QuickLogic-Corp/Salinas/docs/c19054_SALINAS_BOM.XLSX

Sheet: V1.11
QUICK LOGIC | Salinas Evaluation (ETH) | REV: 1.11 (09/14/20)
Value | PCB Footprint | Part Reference | Quantity | DESCRIPTION
0.1uF | SMD_0402 | C1,C3,C5,C7,C9,C10,C13,C15,C17,C19,C21,C23,C25,C27,C29,C32,C36,C49-C57,C59-C63,C65-C68,C70-C95 | 61 | C,.1U,16V,10%,X7R,0402,CR
4.7uF | SMD_0603 | C2,C4,C6,C8,C11,C12,C14,C16,C18,C20,C22,C24,C26,C28,C30,C31,C48,C58,C64 | 19 | C,4.7U,6.3V,10%,X5R,0603,CR
1000pF | SMD_0603 | C33,C38-C40 | 4 | C,1000P,50V,10%,X7R,0603,CR
4.7uF | SMD_0805 | C34 | 1 | C,4.7U,10V,10%,X5R,0805,CR
10uF | SMD_0603 | C35 | 1 | C,10U,6.3V,10%,X5R,0603,CR
10uF | SMD_0805 | C37 | 1 | C,10U,10V,10%,X5R,0805,CR
1uF | SMD_0805 | C41-C44 | 4 | C,1U,16V,10%,X7R,0805,CR
8.2pF | SMD_0402 | C45,C46 | 2 | 8.2pF ±5% 50V Ceramic Capacitor C0G, NP0 0402 (1005 Metric)
10pF | SMD_0402 | C47 | 1 | C,10P,50V,5%,COG/NPO,0402,CR
120pF | SMD_0402 | C69 | 1 | 120pF ±5% 50V Ceramic Capacitor C0G, NP0 0402 (1005 Metric)
LTST-C193KGKT-5A | SMD_0603 | D1,D4 | 2 | LED,GREEN CLEAR,20MA,2V,0603
LTST-C193KFKT-5A | SMD_0603 | D2 | 1 | LED,ORANGE,CLR,5MA,2V,0603
LTST-C193KSKT-5A | SMD_0603 | D3 | 1 | LED,YELLOW CLR,20MA,2.1V,0603
LTST-C193TBKT-5A | SMD_0603 | D5 | 1 | LED,BLUE,5MA,2.8V,0603
MF-MSMF050-2 | FUSE_MF-MSMF050-2 | F1 | 1 | FUSE,0.5A,15V,PTC RESETBL,1812
PLATED_HOLE_4_40 | PLATED_HOLE_4_40 | H1-H6 | 6
68602-132HLF | CONN_16X2-68602-132HLF | J1-J4 | 4 | Connector Header Through Hole 32 position 0.100" (2.54mm)
SMA | SMA_5-1814832-1 | J5 | 1 | CON,SMA JACK 50OHM,STR,TH
PJ-002A | PJ-002A | J6 | 1 | CON,DC PWR 2.1MM 2.5A,R/A,TH
M20-9991046 | conn_10X1-9991046 | J7 | 1 | CONN HEADER VERT 10POS 2.54MM
Micro USB connector | micro USB | J8 | 1 | Micro USB
M20-7830642 | CONN_6X2-M20-7830642 | J9 | 1 | CONN RCPT 12POS 0.1 GOLD PCB
M20-9990446 | conn_04X1-M20-9990446 | J10,J11 | 2 | CONN HEADER VERT 4POS 2.54MM
M20-7831046 | CONN_10X2-M20-7831046 | J12 | 1 | CONN RCPT 20POS 0.1 TIN PCB
D2520-6002-AR | CONN_10X2-D2520-6002 | J13 | 1 | CONN HEADER VERT 20POS 2.54MM
M20-9981046 | CONN_10X2-M20-9981046 | J14 | 1 | CONN HEADER VERT 20POS 2.54MM
MI0805K400R | L0805 | L1,L4-L6 | 4 | FERRITE BEAD 40 OHM 0805 1LN
742792040 | SMD_0805-742792040 | L2 | 1 | FERRITE BEAD 600 OHM 0805 1LN
742792023 | SMD_0805-742792040 | L3 | 1 | FERRITE BEAD 120 OHM 0805 1LN
OSC_12M | OSC_SMD-3_2X2P5MM-ASEMB | OSC1 | 1 | XTAL OSC XO 12.0000MHZ HCMOS SMD
5-146280-3 | SAMTEC-TSW-101-07-G-T-3PX1 | P1-P3,P5,P6 | 5 | CONN HEADER VERT 3POS 2.54MM
5-146280-2 | SAMTEC-TSW-102-08-S-S-2PX1 | P4,P7-P15,P18,P19,P20 | 13 | CONN HEADER VERT 2POS 2.54MM
SAMTEC-TSW-101-08-S-S | CA40_1P | P16,P17 | 2 | CONN HEADER VERT 1POS
IRLML6246/SOT-23 | SOT23 | Q1-Q4 | 4 | MOSFET N-CH 20V 4.1A SOT-23
0E | SMD_0603 | R1-R16,R40,R44 | 18 | R,0.0OHM,0.1W,1%,0603,TF
10K | SMD_0603 | R39,R41,R47,R51 | 4 | R,10.0K,0.1W,1%,0603,TF
1K | SMD_0603 | R17-R22 | 6 | R,1K,0.1W,1%,0603,TF
0 OHM | SMD_0402 | R23-R28,R30,R31,R34 | 9 | R,0.00OHM,0.0625W,JUMP,0402,TF
33E | SMD_0402 | R29,R53-R55,R57 | 5 | R,33.0OHM,0.0625W,1%,0402,TF
1K | SMD_0402 | R33,R35-R37,R85-R88 | 8 | R,1.0K,0.0625W,1%,0402,TF
10K | SMD_0402 | R45,R48,R52,R74-R79,R93-R96 | 13 | R,10.0K,0.0625W,1%,0402,TF
330 | SMD_0603 | R46 | 1 | R,330OHM,0.1W,1%,0603,TF
1K | SMD_0603 | R50 (DNP) | 1
0E | SMD_0402 | R56,R59-R64,R68-R69,R89-R92 | 13 | R,0.00OHM,0.0625W,JUMP,0402,TF
100K | SMD_0402 | R65-R67 | 3 | R,100K,0.0625W,1%,0402,TF
39E | SMD_0402 | R72,R73 | 2 | R,39 OHM 1% 1/16W 0402
270E | SMD_0402 | R80-R82,R84 | 4 | R,270OHM,0.0625W,1%,0402,TF
100E | SMD_0402 | R83 | 1 | R,100OHM,0.0625W,1%,0402,TF
10M | SMD_0402 | R97 | 1 | R,10.0M,0.0625W,1%,0402,TF
200MSP3T1B1M2QE | SW_DPDT | SW1-SW4 | 4 | SWITCH TOGGLE SPDT 3A 120V
TP_R | TP50S | TP1-TP4 | 4 | TEST PAD
ETH 64-QFN | QFN-64 | U1 (QUICK LOGIC SUPPLY AND INSTALL) | 1
TXS0104EDR | TXS0104EDR | U2-U14 | 13 | IC TRNSLTR BIDIRECTIONAL 14SOIC
MIC68200-3.3YML | MIC68200-3_3YML | U15 | 1 | IC REG LIN 3.3V 1A 10MLF
XC6504A1819R-G | USPQ-4B04-XC6504A1819R-G | U16 | 1 | LDO Voltage Regulators, 1.8 V
MIC5308YMT-TR | MIC5308YMT-TR | U17 | 1 | IC REG LIN POS ADJ 150MA 6TMLF
DLN-4MC/ATSAM3U4CA-AU | LQFP100 | U18 | 1 | IC MCU 32BIT 256KB FLASH 100LQFP
ECMF02-4CMX8 | uQFN-8L | U19 | 1 | COMMON MODE CHOKE 2LN SMD ESD
12MHz-405C35B12M00000 | XTAL_4SMD_5x3p2 | Y1 | 1 | CRYSTAL 12.0000MHZ 13PF SMD
LQH068-0590-16ABEW55L | LQH068-0590-16ABEW55L | SKT FOR U1 (QUICK LOGIC SUPPLY AND INSTALL) | 1 | DNP
0E | SMD_0603 | R32,R42,R43,R49 (DNP) | 4
0E | SMD_0402 | R58,R70,R71 (DNP) | 3
10K | SMD_0603 | R38 (DNP) | 1
5-146280-3 | SAMTEC-TSW-101-07-G-T-3PX1 | P5 | 1 | See change to line #33
DNP
CSP
UPDATE

Sheet: V1.1
QUICK LOGIC | Salinas Evaluation (ETH) | REV: 1.1 (09/08/20)
Value | PCB Footprint | Part Reference | Quantity | DESCRIPTION
0.1uF | SMD_0402 | C1,C3,C5,C7,C9,C10,C13,C15,C17,C19,C21,C23,C25,C27,C29,C32,C36,C49-C57,C59-C63,C65-C68,C70-C95 | 61 | C,.1U,16V,10%,X7R,0402,CR
4.7uF | SMD_0603 | C2,C4,C6,C8,C11,C12,C14,C16,C18,C20,C22,C24,C26,C28,C30,C31,C48,C58,C64 | 19 | C,4.7U,6.3V,10%,X5R,0603,CR
1000pF | SMD_0603 | C33,C38-C40 | 4 | C,1000P,50V,10%,X7R,0603,CR
4.7uF | SMD_0805 | C34 | 1 | C,4.7U,10V,10%,X5R,0805,CR
10uF | SMD_0603 | C35 | 1 | C,10U,6.3V,10%,X5R,0603,CR
10uF | SMD_0805 | C37 | 1 | C,10U,10V,10%,X5R,0805,CR
1uF | SMD_0805 | C41-C44 | 4 | C,1U,16V,10%,X7R,0805,CR
8.2pF | SMD_0402 | C45,C46 | 2 | 8.2pF ±5% 50V Ceramic Capacitor C0G, NP0 0402 (1005 Metric)
10pF | SMD_0402 | C47 | 1 | C,10P,50V,5%,COG/NPO,0402,CR
120pF | SMD_0402 | C69 | 1 | 120pF ±5% 50V Ceramic Capacitor C0G, NP0 0402 (1005 Metric)
LTST-C193KGKT-5A | SMD_0603 | D1,D4 | 2 | LED,GREEN CLEAR,20MA,2V,0603
LTST-C193KFKT-5A | SMD_0603 | D2 | 1 | LED,ORANGE,CLR,5MA,2V,0603
LTST-C193KSKT-5A | SMD_0603 | D3 | 1 | LED,YELLOW CLR,20MA,2.1V,0603
LTST-C193TBKT-5A | SMD_0603 | D5 | 1 | LED,BLUE,5MA,2.8V,0603
MF-MSMF050-2 | FUSE_MF-MSMF050-2 | F1 | 1 | FUSE,0.5A,15V,PTC RESETBL,1812
PLATED_HOLE_4_40 | PLATED_HOLE_4_40 | H1-H6 | 6
68602-132HLF | CONN_16X2-68602-132HLF | J1-J4 | 4 | Connector Header Through Hole 32 position 0.100" (2.54mm)
SMA | SMA_5-1814832-1 | J5 | 1 | CON,SMA JACK 50OHM,STR,TH
PJ-002A | PJ-002A | J6 | 1 | CON,DC PWR 2.1MM 2.5A,R/A,TH
M20-9991046 | conn_10X1-9991046 | J7 | 1 | CONN HEADER VERT 10POS 2.54MM
Micro USB connector | micro USB | J8 | 1 | Micro USB
M20-7830642 | CONN_6X2-M20-7830642 | J9 | 1 | CONN RCPT 12POS 0.1 GOLD PCB
M20-9990446 | conn_04X1-M20-9990446 | J10,J11 | 2 | CONN HEADER VERT 4POS 2.54MM
M20-7831046 | CONN_10X2-M20-7831046 | J12 | 1 | CONN RCPT 20POS 0.1 TIN PCB
D2520-6002-AR | CONN_10X2-D2520-6002 | J13 | 1 | CONN HEADER VERT 20POS 2.54MM
M20-9981046 | CONN_10X2-M20-9981046 | J14 | 1 | CONN HEADER VERT 20POS 2.54MM
MI0805K400R | L0805 | L1,L4-L6 | 4 | FERRITE BEAD 40 OHM 0805 1LN
742792040 | SMD_0805-742792040 | L2 | 1 | FERRITE BEAD 600 OHM 0805 1LN
742792023 | SMD_0805-742792040 | L3 | 1 | FERRITE BEAD 120 OHM 0805 1LN
OSC_12M | OSC_SMD-3_2X2P5MM-ASEMB | OSC1 | 1 | XTAL OSC XO 12.0000MHZ HCMOS SMD
5-146280-3 | SAMTEC-TSW-101-07-G-T-3PX1 | P1-P3,P5,P6 | 5 | CONN HEADER VERT 3POS 2.54MM
5-146280-2 | SAMTEC-TSW-102-08-S-S-2PX1 | P4,P7-P15,P18,P19,P20 | 13 | CONN HEADER VERT 2POS 2.54MM
SAMTEC-TSW-101-08-S-S | CA40_1P | P16,P17 | 2 | CONN HEADER VERT 1POS
IRLML6246/SOT-23 | SOT23 | Q1-Q4 | 4 | MOSFET N-CH 20V 4.1A SOT-23
0E | SMD_0603 | R1-R16,R40,R44 | 18 | R,0.0OHM,0.1W,1%,0603,TF
10K | SMD_0603 | R39,R41,R47,R51 | 4 | R,10.0K,0.1W,1%,0603,TF
1K | SMD_0603 | R17-R22 | 6 | R,1K,0.1W,1%,0603,TF
0 OHM | SMD_0402 | R23-R28,R30,R31,R34 | 9 | R,0.00OHM,0.0625W,JUMP,0402,TF
33E | SMD_0402 | R29,R53-R55,R57 | 5 | R,33.0OHM,0.0625W,1%,0402,TF
1K | SMD_0402 | R33,R35-R37,R85-R88 | 8 | R,1.0K,0.0625W,1%,0402,TF
10K | SMD_0402 | R45,R48,R52,R74-R79,R93-R96 | 13 | R,10.0K,0.0625W,1%,0402,TF
330 | SMD_0603 | R46 | 1 | R,330OHM,0.1W,1%,0603,TF
1K | SMD_0603 | R50 (DNP) | 1
0E | SMD_0402 | R56,R59-R64,R68-R69,R89-R92 | 13 | R,0.00OHM,0.0625W,JUMP,0402,TF
100K | SMD_0402 | R65-R67 | 3 | R,100K,0.0625W,1%,0402,TF
39E | SMD_0402 | R72,R73 | 2 | R,39 OHM 1% 1/16W 0402
270E | SMD_0402 | R80-R82,R84 | 4 | R,270OHM,0.0625W,1%,0402,TF
100E | SMD_0402 | R83 | 1 | R,100OHM,0.0625W,1%,0402,TF
10M | SMD_0402 | R97 | 1 | R,10.0M,0.0625W,1%,0402,TF
200MSP3T1B1M2QE | SW_DPDT | SW1-SW4 | 4 | SWITCH TOGGLE SPDT 3A 120V
TP_R | TP50S | TP1-TP4 | 4 | TEST PAD
ETH 64-QFN | QFN-64 | U1 (QUICK LOGIC SUPPLY AND INSTALL) | 1
TXB0104DR | TXB0104DR-TI-D | U2-U14 | 13 | IC TRNSLTR BIDIRECTIONAL 14SOIC
MIC68200-3.3YML | MIC68200-3_3YML | U15 | 1 | IC REG LIN 3.3V 1A 10MLF
XC6504A1819R-G | USPQ-4B04-XC6504A1819R-G | U16 | 1 | LDO Voltage Regulators, 1.8 V
MIC5308YMT-TR | MIC5308YMT-TR | U17 | 1 | IC REG LIN POS ADJ 150MA 6TMLF
DLN-4MC/ATSAM3U4CA-AU | LQFP100 | U18 | 1 | IC MCU 32BIT 256KB FLASH 100LQFP
ECMF02-4CMX8 | uQFN-8L | U19 | 1 | COMMON MODE CHOKE 2LN SMD ESD
12MHz-405C35B12M00000 | XTAL_4SMD_5x3p2 | Y1 | 1 | CRYSTAL 12.0000MHZ 13PF SMD
LQH068-0590-16ABEW55L | LQH068-0590-16ABEW55L | SKT FOR U1 (QUICK LOGIC SUPPLY AND INSTALL) | 1 | DNP
0E | SMD_0603 | R32,R42,R43,R49 (DNP) | 4
0E | SMD_0402 | R58,R70,R71 (DNP) | 3
10K | SMD_0603 | R38 (DNP) | 1
5-146280-3 | SAMTEC-TSW-101-07-G-T-3PX1 | P5 (DNP) | 1
DNP
CSP
UPDATE

Sheet: V1.0
QUICK LOGIC | Salinas Evaluation (ETH) | REV: 1.0 (05/01/19)
Value | PCB Footprint | Part Reference | Quantity | DESCRIPTION
0.1uF | SMD_0402 | C1,C3,C5,C7,C9,C10,C13,C15,C17,C19,C21,C23,C25,C27,C29,C32,C36,C49-C57,C59-C63,C65-C68,C70-C95 | 61 | C,.1U,16V,10%,X7R,0402,CR
4.7uF | SMD_0603 | C2,C4,C6,C8,C11,C12,C14,C16,C18,C20,C22,C24,C26,C28,C30,C31,C48,C58,C64 | 19 | C,4.7U,6.3V,10%,X5R,0603,CR
1000pF | SMD_0603 | C33,C38-C40 | 4 | C,1000P,50V,10%,X7R,0603,CR
4.7uF | SMD_0805 | C34 | 1 | C,4.7U,10V,10%,X5R,0805,CR
10uF | SMD_0603 | C35 | 1 | C,10U,6.3V,10%,X5R,0603,CR
10uF | SMD_0805 | C37 | 1 | C,10U,10V,10%,X5R,0805,CR
1uF | SMD_0805 | C41-C44 | 4 | C,1U,16V,10%,X7R,0805,CR
8.2pF | SMD_0402 | C45,C46 | 2 | 8.2pF ±5% 50V Ceramic Capacitor C0G, NP0 0402 (1005 Metric)
10pF | SMD_0402 | C47 | 1 | C,10P,50V,5%,COG/NPO,0402,CR
120pF | SMD_0402 | C69 | 1 | 120pF ±5% 50V Ceramic Capacitor C0G, NP0 0402 (1005 Metric)
LTST-C193KGKT-5A | SMD_0603 | D1,D4 | 2 | LED,GREEN CLEAR,20MA,2V,0603
LTST-C193KFKT-5A | SMD_0603 | D2 | 1 | LED,ORANGE,CLR,5MA,2V,0603
LTST-C193KSKT-5A | SMD_0603 | D3 | 1 | LED,YELLOW CLR,20MA,2.1V,0603
LTST-C193TBKT-5A | SMD_0603 | D5 | 1 | LED,BLUE,5MA,2.8V,0603
MF-MSMF050-2 | FUSE_MF-MSMF050-2 | F1 | 1 | FUSE,0.5A,15V,PTC RESETBL,1812
PLATED_HOLE_4_40 | PLATED_HOLE_4_40 | H1-H6 | 6
68602-132HLF | CONN_16X2-68602-132HLF | J1-J4 | 4 | Connector Header Through Hole 32 position 0.100" (2.54mm)
SMA | SMA_5-1814832-1 | J5 | 1 | CON,SMA JACK 50OHM,STR,TH
PJ-002A | PJ-002A | J6 | 1 | CON,DC PWR 2.1MM 2.5A,R/A,TH
M20-9991046 | conn_10X1-9991046 | J7 | 1 | CONN HEADER VERT 10POS 2.54MM
USB A Plug - 1002-015-01001 | USB_TYPE_A | J8 | 1 | CONN PLUG USB2.0 TYPEA 4POS R/A
M20-7830642 | CONN_6X2-M20-7830642 | J9 | 1 | CONN RCPT 12POS 0.1 GOLD PCB
M20-9990446 | conn_04X1-M20-9990446 | J10,J11 | 2 | CONN HEADER VERT 4POS 2.54MM
M20-7831046 | CONN_10X2-M20-7831046 | J12 | 1 | CONN RCPT 20POS 0.1 TIN PCB
D2520-6002-AR | CONN_10X2-D2520-6002 | J13 | 1 | CONN HEADER VERT 20POS 2.54MM
M20-9981046 | CONN_10X2-M20-9981046 | J14 | 1 | CONN HEADER VERT 20POS 2.54MM
MI0805K400R | L0805 | L1,L4-L6 | 4 | FERRITE BEAD 40 OHM 0805 1LN
742792040 | SMD_0805-742792040 | L2 | 1 | FERRITE BEAD 600 OHM 0805 1LN
742792023 | SMD_0805-742792040 | L3 | 1 | FERRITE BEAD 120 OHM 0805 1LN
OSC_12M | OSC_SMD-3_2X2P5MM-ASEMB | OSC1 | 1 | XTAL OSC XO 12.0000MHZ HCMOS SMD
5-146280-3 | SAMTEC-TSW-101-07-G-T-3PX1 | P1-P3,P6 | 4 | CONN HEADER VERT 3POS 2.54MM
5-146280-2 | SAMTEC-TSW-102-08-S-S-2PX1 | P4,P7-P15,P18,P19 | 12 | CONN HEADER VERT 2POS 2.54MM
SAMTEC-TSW-101-08-S-S | CA40_1P | P16,P17 | 2 | CONN HEADER VERT 1POS
IRLML6246/SOT-23 | SOT23 | Q1-Q4 | 4 | MOSFET N-CH 20V 4.1A SOT-23
0E | SMD_0603 | R1-R16,R40,R44 | 18 | R,0.0OHM,0.1W,1%,0603,TF
10K | SMD_0603 | R17-R22,R39,R41,R47,R51 | 10 | R,10.0K,0.1W,1%,0603,TF
0 OHM | SMD_0402 | R23-R28,R30,R31 | 8 | R,0.00OHM,0.0625W,JUMP,0402,TF
33E | SMD_0402 | R29,R53-R55,R57 | 5 | R,33.0OHM,0.0625W,1%,0402,TF
1K | SMD_0402 | R33,R85-R88 | 5 | R,1.0K,0.0625W,1%,0402,TF
10K | SMD_0402 | R34-R37,R45,R48,R52,R74-R79,R93-R96 | 17 | R,10.0K,0.0625W,1%,0402,TF
330 | SMD_0603 | R46 | 1 | R,330OHM,0.1W,1%,0603,TF
1K | SMD_0603 | R50 (DNP) | 1
0E | SMD_0402 | R56,R59-R64,R68-R69,R89-R92 | 13 | R,0.00OHM,0.0625W,JUMP,0402,TF
100K | SMD_0402 | R65-R67 | 3 | R,100K,0.0625W,1%,0402,TF
39E | SMD_0402 | R72,R73 | 2 | R,39 OHM 1% 1/16W 0402
270E | SMD_0402 | R80-R82,R84 | 4 | R,270OHM,0.0625W,1%,0402,TF
100E | SMD_0402 | R83 | 1 | R,100OHM,0.0625W,1%,0402,TF
10M | SMD_0402 | R97 | 1 | R,10.0M,0.0625W,1%,0402,TF
200MSP3T1B1M2QE | SW_DPDT | SW1-SW4 | 4 | SWITCH TOGGLE SPDT 3A 120V
TP_R | TP50S | TP1-TP4 | 4 | TEST PAD
ETH 64-QFN | LQH068-0590-16ABEW55L | U1 (QUICK LOGIC SUPPLY AND INSTALL) | 1
TXB0104DR | TXB0104DR-TI-D | U2-U14 | 13 | IC TRNSLTR BIDIRECTIONAL 14SOIC
MIC68200-3.3YML | MIC68200-3_3YML | U15 | 1 | IC REG LIN 3.3V 1A 10MLF
XC6504A1819R-G | USPQ-4B04-XC6504A1819R-G | U16 | 1 | LDO Voltage Regulators, 1.8 V
MIC5308YMT-TR | MIC5308YMT-TR | U17 | 1 | IC REG LIN POS ADJ 150MA 6TMLF
DLN-4MC/ATSAM3U4CA-AU | LQFP100 | U18 | 1 | IC MCU 32BIT 256KB FLASH 100LQFP
ECMF02-4CMX8 | uQFN-8L | U19 | 1 | COMMON MODE CHOKE 2LN SMD ESD
12MHz-405C35B12M00000 | XTAL_4SMD_5x3p2 | Y1 | 1 | CRYSTAL 12.0000MHZ 13PF SMD
LQH068-0590-16ABEW55L | LQH068-0590-16ABEW55L | SKT FOR U1 (QUICK LOGIC SUPPLY AND INSTALL) | 1
0E | SMD_0603 | R32,R42,R43,R49 (DNP) | 4
0E | SMD_0402 | R58,R70,R71 (DNP) | 3
10K | SMD_0603 | R38 (DNP) | 1
5-146280-3 | SAMTEC-TSW-101-07-G-T-3PX1 | P5 (DNP) | 1
DNP
CSP
