QuickLogic-Corp/Salinas/(list of files, drawings)

Other design files:
sources/C19054_SALINAS.DSN
