QuickLogic-Corp/Salinas/(commit log)

2020-10-27 1. Schematic in PDF 2. BOM 3. Schematic source: Orcad 4. Layout: Allegro
    [C19054_SALINAS.DSN, c19054_SALINAS_BOM.XLSX]
2020-10-28 Update schematic to match with Reworks
    [C19054_SALINAS.DSN]
